ciaa/CIAA_ACC/README.md

# CIAA ACC

Here you will find [documentation](doc), [demos](demos) and more resources ([Hardware](hw), [Linux](linux) and [Support](support)) to work with this board, developed by [INTI](http://www.inti.gob.ar/) - [Micro and Nanotechnologies](https://www.inti.gob.ar/areas/desarrollo-tecnologico-e-innovacion/areas-de-conocimiento/micro-y-nanotecnologias) and [Emtech](https://www.emtech.com.ar/) as part of the [CIAA project](http://www.proyecto-ciaa.com.ar/).

## License


This work is licensed under a [Creative Commons Attribution 4.0 International License](http://creativecommons.org/licenses/by/4.0).
See [LICENSE](LICENSE) for details.
