ciaa/CIAA_ACC/hw/README.md

# Hardware

The CIAA ACC design files are part of the [ciaa/Hardware](https://github.com/ciaa/Hardware) repository, located under the [PCB/ACC/CIAA_ACC](https://github.com/ciaa/Hardware/tree/master/PCB/ACC/CIAA_ACC) directory.

Here you find the CIAA ACC [Schematic](ciaa_acc_schematic.pdf) and the [Master Constraints File](ciaa_acc_master.xdc).
