ciaa/CIAA_ACC/support/README.md

# Support

* [Board Definition files](bdf) for Vivado (Xilinx).
* [Firmware](lpc) for the LPC11U35.
