ciaa/CIAA_ACC/support/bdf/README.md

# How to use

Copy the *ciaa-acc* folder to *<VIVADO_INSTALL_DIR>/data/boards/board_files/*.

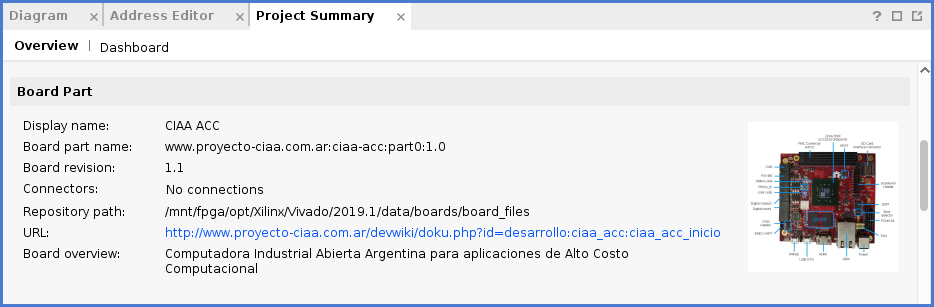
[picture p1: doc/images/bdf.png]
Vivado BDF


If you don't want to install the board files, you can use `presets.tcl` instead:
* Select `xc7z030fbg676-2` as the FPGA part of the project.
* *Re-Customize* (double click) the Zynq IP.
* Select *Presets* -> *Apply configurations...*
* Browse and select `presets.tcl`
