ciaa/CIAA_ACC/(threads)

Thread 2 (2019-09-12):

Nombre de proveedor en Board File Description

gguichal, 2019-09-12:
Propongo cambiar nombre de proveedor a "CIAA Project", o algo así y no dejar el url como nombre del proveedor. Me gusta el CIAA al inicio en vez de "Proyecto CIAA", pero podría también ser eso otro.

nscotti, 2019-09-13:
Listo! Ya edité el archivo board.xml.

martinribelotta, 2019-09-13:
@nscotti cuando hagas un commit y que sea la solución a un bug, agrega la frase "fix #<el numbero del commit>" asi github lo cierra automaticamente.

Por ejemplo, un commit que cierre esta issue seria:

Fix name on board.xml, this fix #2

Closed 2019-09-13.
