ciaa/CIAA_ACC/(commit log)

2017-10-18 Added board images (front and back)
2017-10-18 Added an empty Board Defininition File for Vivado
2017-10-20 Added the minimum information in the bdf to be interpreted by Vivado
    Board name and used FPGA.
2017-11-13 Linux: Add first stage BSP support
2017-12-01 * Improve Linux BSD support
    - kernel: QSPI flash support
    - u-boot: add support for u-boot xilinx 2017.3 with SPL
    - fpga: fpga load over u-boot
    - buildroot: split devicetree, uImage and initramfs due to load via u-boot
    - packages:
    - flash utilities
    - tcl, bash and micropython internerets
    - nano and top
    - can utilities
    - ssh and telnet support
2018-02-21 Added doc/FMC_HPC.fods
    Pin map between the FMC HPC connector and the FPGA.
2018-02-21 Fixed pin map of CLK1_M2C
    In doc/FMC_HPC.fods
2018-02-21 Fixed link to board image in doc/README.md
2018-02-21 Added description about FMC HPC connector in doc/README.md
2018-02-26 Added sections Boot Selection and User LEDs to doc/README.md
2018-02-27 Added sections power, clock and fan to doc/README.md
2018-03-05 Added POWER graphic and explanation to doc/README.md
2018-03-05 Added annex A to doc/README.md
    Simulated propagation times in the FMC connector.
2018-03-25 Added information about I2C, SPI and GPIOs in doc/README.md
2018-03-25 Added LEDs, GPIOs, Digital IOs and FAN constraints to doc/ciaa_acc_master.xdc
    Fixed the rest of constraints (unneeded {}).
    [ciaa_acc_master.xdc]
2018-03-25 Added UART (PL) info a constraints in doc
2018-03-25 Fixes in doc/images/block.png
    * SPI is connected to the PS.
    * XADC was not implemented.
    * There are 8 GPIOs in the Expansion Header (instead of 16).
2018-03-26 Fixed GPIOs names in ciaa_acc_master.xdc
    [ciaa_acc_master.xdc]
2018-05-19 Add Linux BSP and TCL Vivado changes
    - Add MIO tcl script for zynq PL initialization
    - Add USB host devicetree support
    - Add make-buildroot.sh script for easy startup
2018-05-20 Fix devicetable of buildroot for init.d files permission
2018-11-13 Added dap_cdc.bin
    Firmware to use the LPC11U35 as DAP and UART.
2019-06-19 Corregí error en la tabla Gigabit Interface. Esto es un aporte de Bruno Valinoti y alguien más del ICTP.
2019-09-13 Updated vendor on board.xml.
2019-10-08 Moved FMC_HPC.fods and board.fodg to images under the doc directory
2019-10-18 Added doc/images/bdf.png
    Board information in the Vivado's Project Summary screen.
2019-10-18 Updated the schematic (pdf version 1.4)
2020-02-26 Revert "Merge branch 'master' of https://github.com/ciaa/CIAA_ACC_Support.git"
    This reverts commit 70a8207f078c4e000b3747eaba9857c347ca4ac4.
    [ciaa_acc_master.xdc]
2020-02-26 Revert "Revert "Merge branch 'master' of https://github.com/ciaa/CIAA_ACC_Support.git""
    This reverts commit d0ba0c714fc55e3be1ed0a369221c0f9aaf2be83.
    [ciaa_acc_master.xdc]
2020-03-12 Added an schema about how to connect a JTAG HS3 into the J6 connector
    images.fodg is used to compose images.
